vpxavier/rowenta-esp32-mqtt-bridge/docs/schema.webp

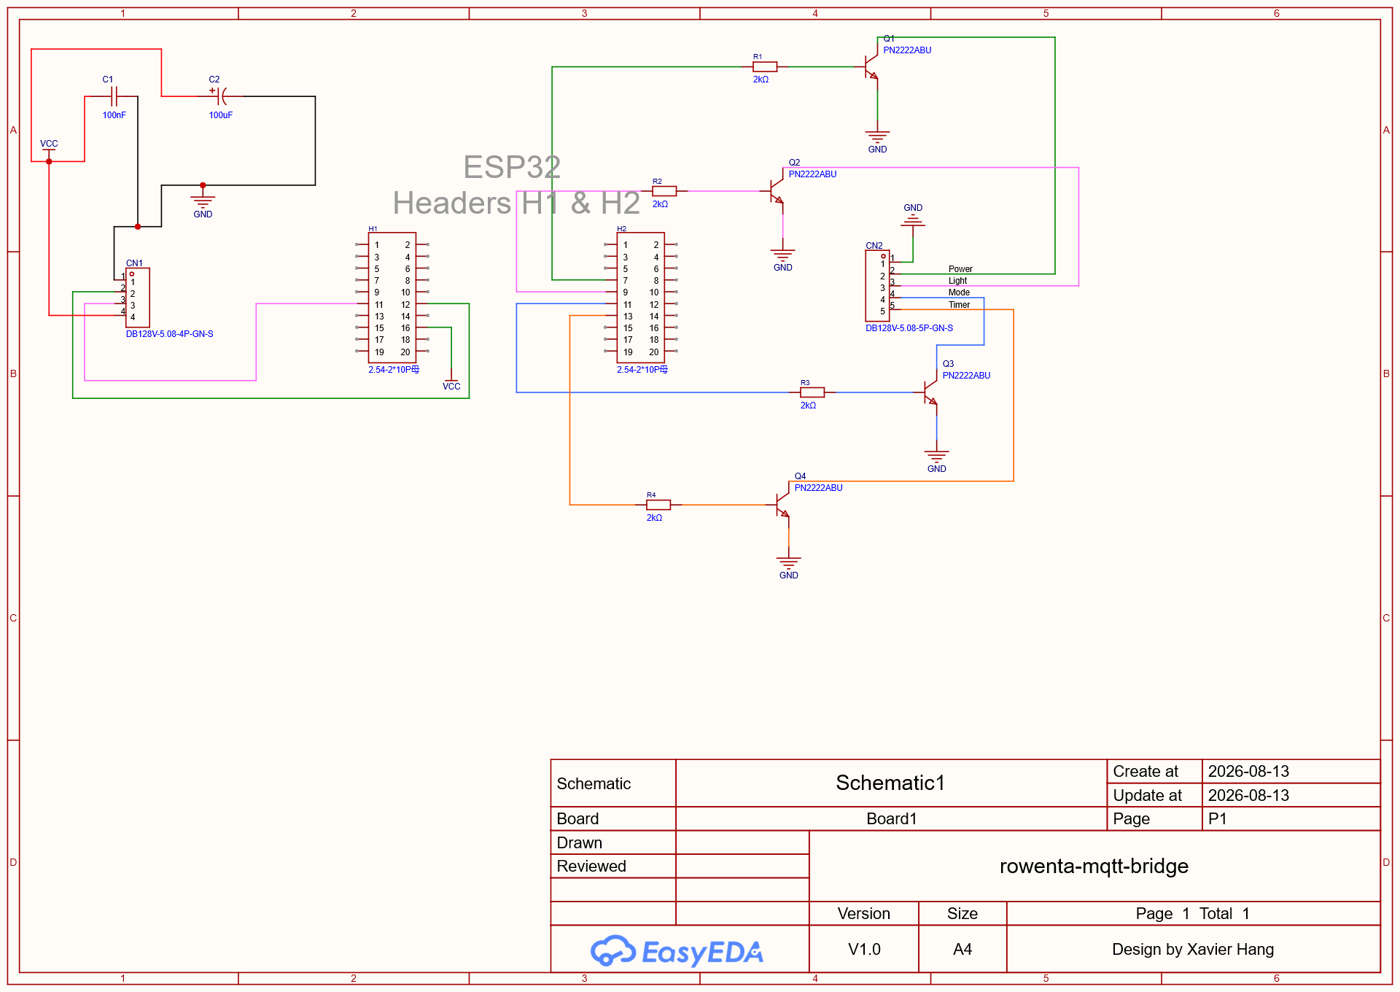
docs/schema.webp
