vpxavier/rowenta-esp32-mqtt-bridge/docs/BOM_Rowenta-ESP32-MQTT-Bridge_Rowenta-ESP32-MQTT-Bridge_2026-08-13.xlsx

No. | Quantity | Comment | Designator | Footprint | Value | Manufacturer Part | Manufacturer | Supplier Part | Supplier
1 | 1 | 100nF | C1 | CAP-TH_L5.8-W2.4-P2.54-D0.6 | 100nF | CC1H104ZA1ED3F5P1100 | Dersonic(德尔创) | C2832506 | LCSC
2 | 1 | 100uF | C2 | CAP-TH_BD5.0-P2.00-D0.5-FD-A | 100uF | RD1C107M05011PC350 | SAMWHA(三和) | C18214320 | LCSC
3 | 1 | DB128V-5.08-4P-GN-S | CN1 | CONN-TH_4P-P5.08_DIBO_DB128V-5.08 |  | DB128V-5.08-4P-GN-S | DORABO(地博电气) | C2915641 | LCSC
4 | 1 | DB128V-5.08-5P-GN-S | CN2 | CONN-TH_5P-P5.08_DIBO_DB128V-5.08-5P-GN-S |  | DB128V-5.08-5P-GN-S | DORABO(地博电气) | C2927513 | LCSC
5 | 2 | 2.54-2*10P母 | H1,H2 | HDR-TH_20P-P2.54-V-F-R2-C10-S2.54 |  | 2.54-2*10P母 | BOOMELE(博穆精密) | C30867 | LCSC
6 | 4 | PN2222ABU | Q1,Q2,Q3,Q4 | TO-92-3_L4.8-W3.7-P1.27-L-1 |  | PN2222ABU | onsemi(安森美) | C896866 | LCSC
7 | 4 | 2kΩ | R1,R2,R3,R4 | RES-TH_BD2.4-L6.3-P10.30-D0.6 | 2kΩ | MFR-25FBF52-2K | YAGEO(国巨) | C1365853 | LCSC
