vpxavier/rowenta-esp32-mqtt-bridge/(commit log)

2026-08-13 Add bilingual web UI (FR/EN), fix OTA watchdog timeout during upload, update README with localized screenshots
    [firmware_rowenta_pur_air_connect_xl_mqtt_bridge.ino]
2026-08-13 Rename firmware to match corrected product name (Intense Pure Air Connect XL)
    [firmware_rowenta_intense_pure_air_connect_xl_mqtt_bridge.ino]
2026-08-14 Add version number, changelog, fix page title and add footer with author/version
    [firmware_rowenta_intense_pure_air_connect_xl_mqtt_bridge.ino]
2026-08-14 v1.0.1: UI lockout during commands, auto-reload after OTA, fix OTA watchdog, add author label to footer
    [firmware_rowenta_intense_pure_air_connect_xl_mqtt_bridge.ino]
